nhpoole/mixed_signal_mmwave_edge_accelerator/simulations/cap_mult_test.spice

**.subckt cap_mult_test
C1 vcap GND 'Clpf' m=1 
R2 vbuf vlpf 'Rbase' m=1 
R3 vcap vlpf 'Kcap*Rbase' m=1 
R1 vlpf vin 'Rlpf' m=1 
x1 vbuf vcap vbuf se_fold_casc_wide_swing_opamp
**** begin user architecture code

.include ~/skywater-pdk/libraries/sky130_fd_pr_ngspice/latest/cells/nfet_01v8/sky130_fd_pr__nfet_01v8__tt.corner.spice
.include ~/skywater-pdk/libraries/sky130_fd_pr_ngspice/latest/cells/nfet_01v8_lvt/sky130_fd_pr__nfet_01v8_lvt__tt.corner.spice
.include ~/skywater-pdk/libraries/sky130_fd_pr_ngspice/latest/cells/pfet_01v8/sky130_fd_pr__pfet_01v8__tt.corner.spice
.include ~/skywater-pdk/libraries/sky130_fd_pr_ngspice/latest/cells/nfet_03v3_nvt/sky130_fd_pr__nfet_03v3_nvt__tt.corner.spice
.include ~/skywater-pdk/libraries/sky130_fd_pr_ngspice/latest/cells/nfet_05v0_nvt/sky130_fd_pr__nfet_05v0_nvt__tt.corner.spice
.include ~/skywater-pdk/libraries/sky130_fd_pr_ngspice/latest/cells/esd_nfet_01v8/sky130_fd_pr__esd_nfet_01v8__tt.corner.spice
.include ~/skywater-pdk/libraries/sky130_fd_pr_ngspice/latest/cells/pfet_01v8_lvt/sky130_fd_pr__pfet_01v8_lvt__tt.corner.spice
.include ~/skywater-pdk/libraries/sky130_fd_pr_ngspice/latest/cells/pfet_01v8_hvt/sky130_fd_pr__pfet_01v8_hvt__tt.corner.spice
.include ~/skywater-pdk/libraries/sky130_fd_pr_ngspice/latest/cells/esd_pfet_g5v0d10v5/sky130_fd_pr__esd_pfet_g5v0d10v5__tt.corner.spice
.include ~/skywater-pdk/libraries/sky130_fd_pr_ngspice/latest/cells/pfet_g5v0d10v5/sky130_fd_pr__pfet_g5v0d10v5__tt.corner.spice
.include ~/skywater-pdk/libraries/sky130_fd_pr_ngspice/latest/cells/pfet_g5v0d16v0/sky130_fd_pr__pfet_g5v0d16v0__tt.corner.spice
.include ~/skywater-pdk/libraries/sky130_fd_pr_ngspice/latest/cells/nfet_g5v0d10v5/sky130_fd_pr__nfet_g5v0d10v5__tt.corner.spice
.include ~/skywater-pdk/libraries/sky130_fd_pr_ngspice/latest/cells/nfet_g5v0d16v0/sky130_fd_pr__nfet_g5v0d16v0__tt_discrete.corner.spice
.include ~/skywater-pdk/libraries/sky130_fd_pr_ngspice/latest/cells/esd_nfet_g5v0d10v5/sky130_fd_pr__esd_nfet_g5v0d10v5__tt.corner.spice
.include ~/skywater-pdk/libraries/sky130_fd_pr_ngspice/latest/models/corners/tt/nonfet.spice
* Mismatch parameters
.include ~/skywater-pdk/libraries/sky130_fd_pr_ngspice/latest/cells/nfet_01v8/sky130_fd_pr__nfet_01v8__mismatch.corner.spice
.include ~/skywater-pdk/libraries/sky130_fd_pr_ngspice/latest/cells/pfet_01v8/sky130_fd_pr__pfet_01v8__mismatch.corner.spice
.include ~/skywater-pdk/libraries/sky130_fd_pr_ngspice/latest/cells/nfet_01v8_lvt/sky130_fd_pr__nfet_01v8_lvt__mismatch.corner.spice
.include ~/skywater-pdk/libraries/sky130_fd_pr_ngspice/latest/cells/pfet_01v8_lvt/sky130_fd_pr__pfet_01v8_lvt__mismatch.corner.spice
.include ~/skywater-pdk/libraries/sky130_fd_pr_ngspice/latest/cells/pfet_01v8_hvt/sky130_fd_pr__pfet_01v8_hvt__mismatch.corner.spice
.include ~/skywater-pdk/libraries/sky130_fd_pr_ngspice/latest/cells/nfet_g5v0d10v5/sky130_fd_pr__nfet_g5v0d10v5__mismatch.corner.spice
.include ~/skywater-pdk/libraries/sky130_fd_pr_ngspice/latest/cells/pfet_g5v0d10v5/sky130_fd_pr__pfet_g5v0d10v5__mismatch.corner.spice
.include ~/skywater-pdk/libraries/sky130_fd_pr_ngspice/latest/cells/nfet_05v0_nvt/sky130_fd_pr__nfet_05v0_nvt__mismatch.corner.spice
.include ~/skywater-pdk/libraries/sky130_fd_pr_ngspice/latest/cells/nfet_03v3_nvt/sky130_fd_pr__nfet_03v3_nvt__mismatch.corner.spice
* Resistor~/skywater-pdk/libraries/sky130_fd_pr_ngspice/latest/Capacitor
.include ~/skywater-pdk/libraries/sky130_fd_pr_ngspice/latest/models/r+c/res_typical__cap_typical.spice
.include ~/skywater-pdk/libraries/sky130_fd_pr_ngspice/latest/models/r+c/res_typical__cap_typical__lin.spice
* Special cells
.include ~/skywater-pdk/libraries/sky130_fd_pr_ngspice/latest/models/corners/tt/specialized_cells.spice
* All models
.include ~/skywater-pdk/libraries/sky130_fd_pr_ngspice/latest/models/all.spice
* Corner
.include ~/skywater-pdk/libraries/sky130_fd_pr_ngspice/latest/models/corners/tt/rf.spice

**** end user architecture code
**.ends

* expanding   symbol:
*+  /home/users/nhpoole/ee272b/ee272b_mixed_signal_mmwave_accelerator/designs/se_fold_casc_wide_swing_opamp.sym # of pins=3
* sym_path:
*+ /home/users/nhpoole/ee272b/ee272b_mixed_signal_mmwave_accelerator/designs/se_fold_casc_wide_swing_opamp.sym
* sch_path:
*+ /home/users/nhpoole/ee272b/ee272b_mixed_signal_mmwave_accelerator/designs/se_fold_casc_wide_swing_opamp.sch
.subckt se_fold_casc_wide_swing_opamp  vo vip vim
*.ipin vip
*.ipin vim
*.opin vo
V6 vtail_cascn net1 0
XM7 net1 vbias4 GND GND sky130_fd_pr__nfet_01v8 L='Lbias*nfactorL' W='Wbias*nfactorW' nf=1 ad='int((nf+1)/2) * W/nf * 0.29'
+ as='int((nf+2)/2) * W/nf * 0.29' pd='2*int((nf+1)/2) * (W/nf + 0.29)' ps='2*int((nf+2)/2) * (W/nf + 0.29)'
+ nrd='0.29 / W' nrs='0.29 / W' sa=0 sb=0 sd=0 mult='9*K' m='9*K' 
XM10 vcascnp vbias4 GND GND sky130_fd_pr__nfet_01v8 L='Lbias*nfactorL' W='2*Wbias*nfactorW' nf=1 ad='int((nf+1)/2) * W/nf * 0.29'
+ as='int((nf+2)/2) * W/nf * 0.29' pd='2*int((nf+1)/2) * (W/nf + 0.29)' ps='2*int((nf+2)/2) * (W/nf + 0.29)'
+ nrd='0.29 / W' nrs='0.29 / W' sa=0 sb=0 sd=0 mult='9*K' m='9*K' 
XM11 net11 vbias3 vcascnp GND sky130_fd_pr__nfet_01v8 L='Lbias*nfactorL' W='Wbias*nfactorW' nf=1 ad='int((nf+1)/2) * W/nf * 0.29'
+ as='int((nf+2)/2) * W/nf * 0.29' pd='2*int((nf+1)/2) * (W/nf + 0.29)' ps='2*int((nf+2)/2) * (W/nf + 0.29)'
+ nrd='0.29 / W' nrs='0.29 / W' sa=0 sb=0 sd=0 mult='9*K' m='9*K' 
XM27 vcascnm vbias4 GND GND sky130_fd_pr__nfet_01v8 L='Lbias*nfactorL' W='2*Wbias*nfactorW' nf=1 ad='int((nf+1)/2) * W/nf * 0.29'
+ as='int((nf+2)/2) * W/nf * 0.29' pd='2*int((nf+1)/2) * (W/nf + 0.29)' ps='2*int((nf+2)/2) * (W/nf + 0.29)'
+ nrd='0.29 / W' nrs='0.29 / W' sa=0 sb=0 sd=0 mult='9*K' m='9*K' 
XM28 vo vbias3 vcascnm GND sky130_fd_pr__nfet_01v8 L='Lbias*nfactorL' W='Wbias*nfactorW' nf=1 ad='int((nf+1)/2) * W/nf * 0.29'
+ as='int((nf+2)/2) * W/nf * 0.29' pd='2*int((nf+1)/2) * (W/nf + 0.29)' ps='2*int((nf+2)/2) * (W/nf + 0.29)'
+ nrd='0.29 / W' nrs='0.29 / W' sa=0 sb=0 sd=0 mult='9*K' m='9*K' 
XM36 vbias1 vbias2 net7 VDD sky130_fd_pr__pfet_01v8 L='Lbias' W='2*Wbias' nf=1 ad='int((nf+1)/2) * W/nf * 0.29'
+ as='int((nf+2)/2) * W/nf * 0.29' pd='2*int((nf+1)/2) * (W/nf + 0.29)' ps='2*int((nf+2)/2) * (W/nf + 0.29)'
+ nrd='0.29 / W' nrs='0.29 / W' sa=0 sb=0 sd=0 mult='9*K' m='9*K' 
XM37 net4 vbias2 net2 VDD sky130_fd_pr__pfet_01v8 L='Lbias' W='2*Wbias' nf=1 ad='int((nf+1)/2) * W/nf * 0.29'
+ as='int((nf+2)/2) * W/nf * 0.29' pd='2*int((nf+1)/2) * (W/nf + 0.29)' ps='2*int((nf+2)/2) * (W/nf + 0.29)'
+ nrd='0.29 / W' nrs='0.29 / W' sa=0 sb=0 sd=0 mult='9*K' m='9*K' 
XM38 net6 vbias2 net5 VDD sky130_fd_pr__pfet_01v8 L='Lbias' W='2*Wbias' nf=1 ad='int((nf+1)/2) * W/nf * 0.29'
+ as='int((nf+2)/2) * W/nf * 0.29' pd='2*int((nf+1)/2) * (W/nf + 0.29)' ps='2*int((nf+2)/2) * (W/nf + 0.29)'
+ nrd='0.29 / W' nrs='0.29 / W' sa=0 sb=0 sd=0 mult='9*K' m='9*K' 
XM39 vbias2 net3 vbias1 VDD sky130_fd_pr__pfet_01v8 L='Lbias' W='Wbias' nf=1 ad='int((nf+1)/2) * W/nf * 0.29'
+ as='int((nf+2)/2) * W/nf * 0.29' pd='2*int((nf+1)/2) * (W/nf + 0.29)' ps='2*int((nf+2)/2) * (W/nf + 0.29)'
+ nrd='0.29 / W' nrs='0.29 / W' sa=0 sb=0 sd=0 mult='3*K' m='3*K' 
XM40 net3 net3 vbias2 VDD sky130_fd_pr__pfet_01v8 L='Lbias' W='3*Wbias' nf=1 ad='int((nf+1)/2) * W/nf * 0.29'
+ as='int((nf+2)/2) * W/nf * 0.29' pd='2*int((nf+1)/2) * (W/nf + 0.29)' ps='2*int((nf+2)/2) * (W/nf + 0.29)'
+ nrd='0.29 / W' nrs='0.29 / W' sa=0 sb=0 sd=0 mult='9*K' m='9*K' 
XM41 net4 net4 vbias3 GND sky130_fd_pr__nfet_01v8 L='Lbias*nfactorL' W='3*Wbias*nfactorW' nf=1 ad='int((nf+1)/2) * W/nf * 0.29'
+ as='int((nf+2)/2) * W/nf * 0.29' pd='2*int((nf+1)/2) * (W/nf + 0.29)' ps='2*int((nf+2)/2) * (W/nf + 0.29)'
+ nrd='0.29 / W' nrs='0.29 / W' sa=0 sb=0 sd=0 mult='9*K' m='9*K' 
XM42 vbias3 net4 vbias4 GND sky130_fd_pr__nfet_01v8 L='Lbias*nfactorL' W='Wbias*nfactorW' nf=1 ad='int((nf+1)/2) * W/nf * 0.29'
+ as='int((nf+2)/2) * W/nf * 0.29' pd='2*int((nf+1)/2) * (W/nf + 0.29)' ps='2*int((nf+2)/2) * (W/nf + 0.29)'
+ nrd='0.29 / W' nrs='0.29 / W' sa=0 sb=0 sd=0 mult='K' m='K' 
XM43 vbias4 vbias3 net9 GND sky130_fd_pr__nfet_01v8 L='Lbias*nfactorL' W='Wbias*nfactorW' nf=1 ad='int((nf+1)/2) * W/nf * 0.29'
+ as='int((nf+2)/2) * W/nf * 0.29' pd='2*int((nf+1)/2) * (W/nf + 0.29)' ps='2*int((nf+2)/2) * (W/nf + 0.29)'
+ nrd='0.29 / W' nrs='0.29 / W' sa=0 sb=0 sd=0 mult='9*K' m='9*K' 
XM44 net10 vbias4 GND GND sky130_fd_pr__nfet_01v8 L='Lbias*nfactorL' W='Wbias*nfactorW' nf=1 ad='int((nf+1)/2) * W/nf * 0.29'
+ as='int((nf+2)/2) * W/nf * 0.29' pd='2*int((nf+1)/2) * (W/nf + 0.29)' ps='2*int((nf+2)/2) * (W/nf + 0.29)'
+ nrd='0.29 / W' nrs='0.29 / W' sa=0 sb=0 sd=0 mult='9*K' m='9*K' 
XM45 net6 net6 net8 net8 sky130_fd_pr__nfet_01v8 L='Lbias' W='0.6*Wbias' nf=1 ad='int((nf+1)/2) * W/nf * 0.29'
+ as='int((nf+2)/2) * W/nf * 0.29' pd='2*int((nf+1)/2) * (W/nf + 0.29)' ps='2*int((nf+2)/2) * (W/nf + 0.29)'
+ nrd='0.29 / W' nrs='0.29 / W' sa=0 sb=0 sd=0 mult='K' m='K' 
I1 net3 GND 'Ibias' 
V7 net8 GND 0
V8 net9 net10 0
XM8 vfoldp vip vtail_cascn GND sky130_fd_pr__nfet_01v8 L='K2*Lbias*nfactorL' W='Wbias*nfactorW' nf=1
+ ad='int((nf+1)/2) * W/nf * 0.29' as='int((nf+2)/2) * W/nf * 0.29' pd='2*int((nf+1)/2) * (W/nf + 0.29)'
+ ps='2*int((nf+2)/2) * (W/nf + 0.29)' nrd='0.29 / W' nrs='0.29 / W' sa=0 sb=0 sd=0 mult='9*K' m='9*K'
+ 
XM12 net11 vbias2 vfoldp VDD sky130_fd_pr__pfet_01v8 L='Lbias' W='2*Wbias' nf=1 ad='int((nf+1)/2) * W/nf * 0.29'
+ as='int((nf+2)/2) * W/nf * 0.29' pd='2*int((nf+1)/2) * (W/nf + 0.29)' ps='2*int((nf+2)/2) * (W/nf + 0.29)'
+ nrd='0.29 / W' nrs='0.29 / W' sa=0 sb=0 sd=0 mult='9*K' m='9*K' 
XM31 vo vbias2 vfoldm VDD sky130_fd_pr__pfet_01v8 L='Lbias' W='2*Wbias' nf=1 ad='int((nf+1)/2) * W/nf * 0.29'
+ as='int((nf+2)/2) * W/nf * 0.29' pd='2*int((nf+1)/2) * (W/nf + 0.29)' ps='2*int((nf+2)/2) * (W/nf + 0.29)'
+ nrd='0.29 / W' nrs='0.29 / W' sa=0 sb=0 sd=0 mult='9*K' m='9*K' 
XM15 vfoldp net11 VDD VDD sky130_fd_pr__pfet_01v8_lvt L='Lbias' W='4*Wbias' nf=1 ad='int((nf+1)/2) * W/nf * 0.29'
+ as='int((nf+2)/2) * W/nf * 0.29' pd='2*int((nf+1)/2) * (W/nf + 0.29)' ps='2*int((nf+2)/2) * (W/nf + 0.29)'
+ nrd='0.29 / W' nrs='0.29 / W' sa=0 sb=0 sd=0 mult='9*K' m='9*K' 
XM32 vfoldm net11 VDD VDD sky130_fd_pr__pfet_01v8_lvt L='Lbias' W='4*Wbias' nf=1 ad='int((nf+1)/2) * W/nf * 0.29'
+ as='int((nf+2)/2) * W/nf * 0.29' pd='2*int((nf+1)/2) * (W/nf + 0.29)' ps='2*int((nf+2)/2) * (W/nf + 0.29)'
+ nrd='0.29 / W' nrs='0.29 / W' sa=0 sb=0 sd=0 mult='9*K' m='9*K' 
XM33 net7 vbias1 VDD VDD sky130_fd_pr__pfet_01v8_lvt L='Lbias' W='2*Wbias' nf=1 ad='int((nf+1)/2) * W/nf * 0.29'
+ as='int((nf+2)/2) * W/nf * 0.29' pd='2*int((nf+1)/2) * (W/nf + 0.29)' ps='2*int((nf+2)/2) * (W/nf + 0.29)'
+ nrd='0.29 / W' nrs='0.29 / W' sa=0 sb=0 sd=0 mult='9*K' m='9*K' 
XM34 net2 vbias1 VDD VDD sky130_fd_pr__pfet_01v8_lvt L='Lbias' W='2*Wbias' nf=1 ad='int((nf+1)/2) * W/nf * 0.29'
+ as='int((nf+2)/2) * W/nf * 0.29' pd='2*int((nf+1)/2) * (W/nf + 0.29)' ps='2*int((nf+2)/2) * (W/nf + 0.29)'
+ nrd='0.29 / W' nrs='0.29 / W' sa=0 sb=0 sd=0 mult='9*K' m='9*K' 
XM35 net5 vbias1 VDD VDD sky130_fd_pr__pfet_01v8_lvt L='Lbias' W='2*Wbias' nf=1 ad='int((nf+1)/2) * W/nf * 0.29'
+ as='int((nf+2)/2) * W/nf * 0.29' pd='2*int((nf+1)/2) * (W/nf + 0.29)' ps='2*int((nf+2)/2) * (W/nf + 0.29)'
+ nrd='0.29 / W' nrs='0.29 / W' sa=0 sb=0 sd=0 mult='9*K' m='9*K' 
XM5 net1 vbias4 GND GND sky130_fd_pr__nfet_01v8 L='Lbias*nfactorL' W='Wbias*nfactorW' nf=1 ad='int((nf+1)/2) * W/nf * 0.29'
+ as='int((nf+2)/2) * W/nf * 0.29' pd='2*int((nf+1)/2) * (W/nf + 0.29)' ps='2*int((nf+2)/2) * (W/nf + 0.29)'
+ nrd='0.29 / W' nrs='0.29 / W' sa=0 sb=0 sd=0 mult='9*K' m='9*K' 
XM9 vfoldm vim vtail_cascn GND sky130_fd_pr__nfet_01v8 L='K2*Lbias*nfactorL' W='Wbias*nfactorW' nf=1
+ ad='int((nf+1)/2) * W/nf * 0.29' as='int((nf+2)/2) * W/nf * 0.29' pd='2*int((nf+1)/2) * (W/nf + 0.29)'
+ ps='2*int((nf+2)/2) * (W/nf + 0.29)' nrd='0.29 / W' nrs='0.29 / W' sa=0 sb=0 sd=0 mult='9*K' m='9*K'
+ 
XM4 vo_sf vbias4 GND GND sky130_fd_pr__nfet_01v8 L='Lbias*nfactorL' W='Wbias*nfactorW' nf=1 ad='int((nf+1)/2) * W/nf * 0.29'
+ as='int((nf+2)/2) * W/nf * 0.29' pd='2*int((nf+1)/2) * (W/nf + 0.29)' ps='2*int((nf+2)/2) * (W/nf + 0.29)'
+ nrd='0.29 / W' nrs='0.29 / W' sa=0 sb=0 sd=0 mult='1*K' m='1*K' 
XM14 GND vo_sf vo_cs VDD sky130_fd_pr__pfet_01v8_lvt L='Lbias' W='4*Wbias' nf=1 ad='int((nf+1)/2) * W/nf * 0.29'
+ as='int((nf+2)/2) * W/nf * 0.29' pd='2*int((nf+1)/2) * (W/nf + 0.29)' ps='2*int((nf+2)/2) * (W/nf + 0.29)'
+ nrd='0.29 / W' nrs='0.29 / W' sa=0 sb=0 sd=0 mult='18*K' m='18*K' 
XM16 vo_cs vbias1 VDD VDD sky130_fd_pr__pfet_01v8_lvt L='Lbias' W='0.5*Wbias' nf=1 ad='int((nf+1)/2) * W/nf * 0.29'
+ as='int((nf+2)/2) * W/nf * 0.29' pd='2*int((nf+1)/2) * (W/nf + 0.29)' ps='2*int((nf+2)/2) * (W/nf + 0.29)'
+ nrd='0.29 / W' nrs='0.29 / W' sa=0 sb=0 sd=0 mult='1*K' m='1*K' 
C1 vcascnm vo_sf 0p m=1
XM6 net12 vbias1 VDD VDD sky130_fd_pr__pfet_01v8_lvt L='Lbias' W='2*Wbias' nf=1 ad='int((nf+1)/2) * W/nf * 0.29'
+ as='int((nf+2)/2) * W/nf * 0.29' pd='2*int((nf+1)/2) * (W/nf + 0.29)' ps='2*int((nf+2)/2) * (W/nf + 0.29)'
+ nrd='0.29 / W' nrs='0.29 / W' sa=0 sb=0 sd=0 mult='9*K' m='9*K' 
V1 net12 vtail_cascp 0
XM13 net12 vbias1 VDD VDD sky130_fd_pr__pfet_01v8_lvt L='Lbias' W='2*Wbias' nf=1 ad='int((nf+1)/2) * W/nf * 0.29'
+ as='int((nf+2)/2) * W/nf * 0.29' pd='2*int((nf+1)/2) * (W/nf + 0.29)' ps='2*int((nf+2)/2) * (W/nf + 0.29)'
+ nrd='0.29 / W' nrs='0.29 / W' sa=0 sb=0 sd=0 mult='9*K' m='9*K' 
XM2 vcascnm vim vtail_cascp VDD sky130_fd_pr__pfet_01v8_lvt L='Lbias' W='2*Wbias' nf=1 ad='int((nf+1)/2) * W/nf * 0.29'
+ as='int((nf+2)/2) * W/nf * 0.29' pd='2*int((nf+1)/2) * (W/nf + 0.29)' ps='2*int((nf+2)/2) * (W/nf + 0.29)'
+ nrd='0.29 / W' nrs='0.29 / W' sa=0 sb=0 sd=0 mult='9*K' m='9*K' 
XM3 vcascnp vip vtail_cascp VDD sky130_fd_pr__pfet_01v8_lvt L='Lbias' W='2*Wbias' nf=1 ad='int((nf+1)/2) * W/nf * 0.29'
+ as='int((nf+2)/2) * W/nf * 0.29' pd='2*int((nf+1)/2) * (W/nf + 0.29)' ps='2*int((nf+2)/2) * (W/nf + 0.29)'
+ nrd='0.29 / W' nrs='0.29 / W' sa=0 sb=0 sd=0 mult='9*K' m='9*K' 
XM17 net13 vbias4_ GND GND sky130_fd_pr__nfet_01v8 L='Lbias*nfactorL' W='Wbias*nfactorW' nf=1 ad='int((nf+1)/2) * W/nf * 0.29'
+ as='int((nf+2)/2) * W/nf * 0.29' pd='2*int((nf+1)/2) * (W/nf + 0.29)' ps='2*int((nf+2)/2) * (W/nf + 0.29)'
+ nrd='0.29 / W' nrs='0.29 / W' sa=0 sb=0 sd=0 mult='9*K' m='9*K' 
XM18 vbias4_ vbias4_ GND GND sky130_fd_pr__nfet_01v8 L='Lbias*nfactorL' W='Wbias*nfactorW' nf=1 ad='int((nf+1)/2) * W/nf * 0.29'
+ as='int((nf+2)/2) * W/nf * 0.29' pd='2*int((nf+1)/2) * (W/nf + 0.29)' ps='2*int((nf+2)/2) * (W/nf + 0.29)'
+ nrd='0.29 / W' nrs='0.29 / W' sa=0 sb=0 sd=0 mult='9*K' m='9*K' 
XM19 net15 net15 vbias4_ GND sky130_fd_pr__nfet_01v8 L='Lbias*nfactorL' W='Wbias*nfactorW' nf=1 ad='int((nf+1)/2) * W/nf * 0.29'
+ as='int((nf+2)/2) * W/nf * 0.29' pd='2*int((nf+1)/2) * (W/nf + 0.29)' ps='2*int((nf+2)/2) * (W/nf + 0.29)'
+ nrd='0.29 / W' nrs='0.29 / W' sa=0 sb=0 sd=0 mult='9*K' m='9*K' 
XM20 net14 net15 net13 GND sky130_fd_pr__nfet_01v8 L='Lbias*nfactorL' W='Wbias*nfactorW' nf=1 ad='int((nf+1)/2) * W/nf * 0.29'
+ as='int((nf+2)/2) * W/nf * 0.29' pd='2*int((nf+1)/2) * (W/nf + 0.29)' ps='2*int((nf+2)/2) * (W/nf + 0.29)'
+ nrd='0.29 / W' nrs='0.29 / W' sa=0 sb=0 sd=0 mult='9*K' m='9*K' 
I2 VDD net15 'Ibias' 
XM25 net14 net14 vbias2_ VDD sky130_fd_pr__pfet_01v8 L='Lbias' W='2*Wbias' nf=1 ad='int((nf+1)/2) * W/nf * 0.29'
+ as='int((nf+2)/2) * W/nf * 0.29' pd='2*int((nf+1)/2) * (W/nf + 0.29)' ps='2*int((nf+2)/2) * (W/nf + 0.29)'
+ nrd='0.29 / W' nrs='0.29 / W' sa=0 sb=0 sd=0 mult='9*K' m='9*K' 
XM26 vbias2_ net14 VDD VDD sky130_fd_pr__pfet_01v8_lvt L='Lbias' W='4*Wbias' nf=1 ad='int((nf+1)/2) * W/nf * 0.29'
+ as='int((nf+2)/2) * W/nf * 0.29' pd='2*int((nf+1)/2) * (W/nf + 0.29)' ps='2*int((nf+2)/2) * (W/nf + 0.29)'
+ nrd='0.29 / W' nrs='0.29 / W' sa=0 sb=0 sd=0 mult='9*K' m='9*K' 
XM21 vbias3_ net17 GND GND sky130_fd_pr__nfet_01v8 L='Lbias*nfactorL' W='Wbias*nfactorW' nf=1 ad='int((nf+1)/2) * W/nf * 0.29'
+ as='int((nf+2)/2) * W/nf * 0.29' pd='2*int((nf+1)/2) * (W/nf + 0.29)' ps='2*int((nf+2)/2) * (W/nf + 0.29)'
+ nrd='0.29 / W' nrs='0.29 / W' sa=0 sb=0 sd=0 mult='9*K' m='9*K' 
XM22 net16 vbias4_ GND GND sky130_fd_pr__nfet_01v8 L='Lbias*nfactorL' W='Wbias*nfactorW' nf=1 ad='int((nf+1)/2) * W/nf * 0.29'
+ as='int((nf+2)/2) * W/nf * 0.29' pd='2*int((nf+1)/2) * (W/nf + 0.29)' ps='2*int((nf+2)/2) * (W/nf + 0.29)'
+ nrd='0.29 / W' nrs='0.29 / W' sa=0 sb=0 sd=0 mult='9*K' m='9*K' 
XM23 net19 net15 net16 GND sky130_fd_pr__nfet_01v8 L='Lbias*nfactorL' W='Wbias*nfactorW' nf=1 ad='int((nf+1)/2) * W/nf * 0.29'
+ as='int((nf+2)/2) * W/nf * 0.29' pd='2*int((nf+1)/2) * (W/nf + 0.29)' ps='2*int((nf+2)/2) * (W/nf + 0.29)'
+ nrd='0.29 / W' nrs='0.29 / W' sa=0 sb=0 sd=0 mult='9*K' m='9*K' 
XM24 net17 net17 vbias3_ GND sky130_fd_pr__nfet_01v8 L='Lbias*nfactorL' W='Wbias*nfactorW' nf=1 ad='int((nf+1)/2) * W/nf * 0.29'
+ as='int((nf+2)/2) * W/nf * 0.29' pd='2*int((nf+1)/2) * (W/nf + 0.29)' ps='2*int((nf+2)/2) * (W/nf + 0.29)'
+ nrd='0.29 / W' nrs='0.29 / W' sa=0 sb=0 sd=0 mult='9*K' m='9*K' 
XM29 net17 net19 net18 VDD sky130_fd_pr__pfet_01v8 L='Lbias' W='2*Wbias' nf=1 ad='int((nf+1)/2) * W/nf * 0.29'
+ as='int((nf+2)/2) * W/nf * 0.29' pd='2*int((nf+1)/2) * (W/nf + 0.29)' ps='2*int((nf+2)/2) * (W/nf + 0.29)'
+ nrd='0.29 / W' nrs='0.29 / W' sa=0 sb=0 sd=0 mult='9*K' m='9*K' 
XM30 net18 vbias1_ VDD VDD sky130_fd_pr__pfet_01v8_lvt L='Lbias' W='4*Wbias' nf=1 ad='int((nf+1)/2) * W/nf * 0.29'
+ as='int((nf+2)/2) * W/nf * 0.29' pd='2*int((nf+1)/2) * (W/nf + 0.29)' ps='2*int((nf+2)/2) * (W/nf + 0.29)'
+ nrd='0.29 / W' nrs='0.29 / W' sa=0 sb=0 sd=0 mult='9*K' m='9*K' 
XM46 net19 net19 vbias1_ VDD sky130_fd_pr__pfet_01v8 L='Lbias' W='2*Wbias' nf=1 ad='int((nf+1)/2) * W/nf * 0.29'
+ as='int((nf+2)/2) * W/nf * 0.29' pd='2*int((nf+1)/2) * (W/nf + 0.29)' ps='2*int((nf+2)/2) * (W/nf + 0.29)'
+ nrd='0.29 / W' nrs='0.29 / W' sa=0 sb=0 sd=0 mult='9*K' m='9*K' 
XM47 vbias1_ vbias1_ VDD VDD sky130_fd_pr__pfet_01v8_lvt L='Lbias' W='4*Wbias' nf=1 ad='int((nf+1)/2) * W/nf * 0.29'
+ as='int((nf+2)/2) * W/nf * 0.29' pd='2*int((nf+1)/2) * (W/nf + 0.29)' ps='2*int((nf+2)/2) * (W/nf + 0.29)'
+ nrd='0.29 / W' nrs='0.29 / W' sa=0 sb=0 sd=0 mult='9*K' m='9*K' 
XM1 vo_sf vo_sf VDD VDD sky130_fd_pr__pfet_01v8 L='Lbias' W='3.5*Wbias' nf=1 ad='int((nf+1)/2) * W/nf * 0.29'
+ as='int((nf+2)/2) * W/nf * 0.29' pd='2*int((nf+1)/2) * (W/nf + 0.29)' ps='2*int((nf+2)/2) * (W/nf + 0.29)'
+ nrd='0.29 / W' nrs='0.29 / W' sa=0 sb=0 sd=0 mult='1*K' m='1*K' 
C2 vo GND 1p m=1
.ends

.GLOBAL GND
.GLOBAL VDD
**** begin user architecture code

.include cap_mult_test_commands.spice

**** end user architecture code
** flattened .save nodes
.end
