nhpoole/mixed_signal_mmwave_edge_accelerator/simulations/dff_test.spice

**.subckt dff_test
V1 vpbias net1 0
XM6 net1 vctrl GND GND sky130_fd_pr__nfet_01v8 L='Lnmos' W='Wnbias' nf=1 ad='int((nf+1)/2) * W/nf * 0.29'
+ as='int((nf+2)/2) * W/nf * 0.29' pd='2*int((nf+1)/2) * (W/nf + 0.29)' ps='2*int((nf+2)/2) * (W/nf + 0.29)'
+ nrd='0.29 / W' nrs='0.29 / W' sa=0 sb=0 sd=0 mult='Mnmos' m='Mnmos' 
XM3 vpbias vpbias VDD VDD sky130_fd_pr__pfet_01v8_hvt L='Lpmos' W='Wpbias' nf=1 ad='int((nf+1)/2) * W/nf * 0.29'
+ as='int((nf+2)/2) * W/nf * 0.29' pd='2*int((nf+1)/2) * (W/nf + 0.29)' ps='2*int((nf+2)/2) * (W/nf + 0.29)'
+ nrd='0.29 / W' nrs='0.29 / W' sa=0 sb=0 sd=0 mult='Mpmos' m='Mpmos' 
x1 vpbias net3 vin vctrl cs_ring_osc_stage
x2 vpbias net4 net3 vctrl cs_ring_osc_stage
x3 vpbias net5 net4 vctrl cs_ring_osc_stage
x4 vpbias net6 net5 vctrl cs_ring_osc_stage
x5 vpbias net7 net6 vctrl cs_ring_osc_stage
x6 vpbias net2 net7 vctrl cs_ring_osc_stage
XM21 vin net2 GND GND sky130_fd_pr__nfet_01v8 L='Lnmos' W='Wninv' nf=1 ad='int((nf+1)/2) * W/nf * 0.29'
+ as='int((nf+2)/2) * W/nf * 0.29' pd='2*int((nf+1)/2) * (W/nf + 0.29)' ps='2*int((nf+2)/2) * (W/nf + 0.29)'
+ nrd='0.29 / W' nrs='0.29 / W' sa=0 sb=0 sd=0 mult='Mnmos' m='Mnmos' 
XM22 vin net2 VDD VDD sky130_fd_pr__pfet_01v8_hvt L='Lpmos' W='Wpinv' nf=1 ad='int((nf+1)/2) * W/nf * 0.29'
+ as='int((nf+2)/2) * W/nf * 0.29' pd='2*int((nf+1)/2) * (W/nf + 0.29)' ps='2*int((nf+2)/2) * (W/nf + 0.29)'
+ nrd='0.29 / W' nrs='0.29 / W' sa=0 sb=0 sd=0 mult='Mpmos' m='Mpmos' 
C1 vin GND 1p m=1
XM1 vin2 vin GND GND sky130_fd_pr__nfet_01v8 L=0.15 W=0.65 nf=1 ad='int((nf+1)/2) * W/nf * 0.29' as='int((nf+2)/2) * W/nf * 0.29'
+ pd='2*int((nf+1)/2) * (W/nf + 0.29)' ps='2*int((nf+2)/2) * (W/nf + 0.29)' nrd='0.29 / W' nrs='0.29 / W'
+ sa=0 sb=0 sd=0 mult=1 m=1 
XM2 vin2 vin VDD VDD sky130_fd_pr__pfet_01v8_hvt L=0.15 W=1 nf=1 ad='int((nf+1)/2) * W/nf * 0.29' as='int((nf+2)/2) * W/nf * 0.29'
+ pd='2*int((nf+1)/2) * (W/nf + 0.29)' ps='2*int((nf+2)/2) * (W/nf + 0.29)' nrd='0.29 / W' nrs='0.29 / W'
+ sa=0 sb=0 sd=0 mult=1 m=1 
XM4 vin_buf vin2 GND GND sky130_fd_pr__nfet_01v8 L=0.15 W=0.65 nf=1 ad='int((nf+1)/2) * W/nf * 0.29'
+ as='int((nf+2)/2) * W/nf * 0.29' pd='2*int((nf+1)/2) * (W/nf + 0.29)' ps='2*int((nf+2)/2) * (W/nf + 0.29)'
+ nrd='0.29 / W' nrs='0.29 / W' sa=0 sb=0 sd=0 mult=4 m=4 
XM5 vin_buf vin2 VDD VDD sky130_fd_pr__pfet_01v8_hvt L=0.15 W=1 nf=1 ad='int((nf+1)/2) * W/nf * 0.29'
+ as='int((nf+2)/2) * W/nf * 0.29' pd='2*int((nf+1)/2) * (W/nf + 0.29)' ps='2*int((nf+2)/2) * (W/nf + 0.29)'
+ nrd='0.29 / W' nrs='0.29 / W' sa=0 sb=0 sd=0 mult=4 m=4 
**** begin user architecture code

.include ~/skywater-pdk/libraries/sky130_fd_pr_ngspice/latest/cells/nfet_01v8/sky130_fd_pr__nfet_01v8__tt.corner.spice
.include ~/skywater-pdk/libraries/sky130_fd_pr_ngspice/latest/cells/nfet_01v8_lvt/sky130_fd_pr__nfet_01v8_lvt__tt.corner.spice
.include ~/skywater-pdk/libraries/sky130_fd_pr_ngspice/latest/cells/pfet_01v8/sky130_fd_pr__pfet_01v8__tt.corner.spice
.include ~/skywater-pdk/libraries/sky130_fd_pr_ngspice/latest/cells/nfet_03v3_nvt/sky130_fd_pr__nfet_03v3_nvt__tt.corner.spice
.include ~/skywater-pdk/libraries/sky130_fd_pr_ngspice/latest/cells/nfet_05v0_nvt/sky130_fd_pr__nfet_05v0_nvt__tt.corner.spice
.include ~/skywater-pdk/libraries/sky130_fd_pr_ngspice/latest/cells/esd_nfet_01v8/sky130_fd_pr__esd_nfet_01v8__tt.corner.spice
.include ~/skywater-pdk/libraries/sky130_fd_pr_ngspice/latest/cells/pfet_01v8_lvt/sky130_fd_pr__pfet_01v8_lvt__tt.corner.spice
.include ~/skywater-pdk/libraries/sky130_fd_pr_ngspice/latest/cells/pfet_01v8_hvt/sky130_fd_pr__pfet_01v8_hvt__tt.corner.spice
.include ~/skywater-pdk/libraries/sky130_fd_pr_ngspice/latest/cells/esd_pfet_g5v0d10v5/sky130_fd_pr__esd_pfet_g5v0d10v5__tt.corner.spice
.include ~/skywater-pdk/libraries/sky130_fd_pr_ngspice/latest/cells/pfet_g5v0d10v5/sky130_fd_pr__pfet_g5v0d10v5__tt.corner.spice
.include ~/skywater-pdk/libraries/sky130_fd_pr_ngspice/latest/cells/pfet_g5v0d16v0/sky130_fd_pr__pfet_g5v0d16v0__tt.corner.spice
.include ~/skywater-pdk/libraries/sky130_fd_pr_ngspice/latest/cells/nfet_g5v0d10v5/sky130_fd_pr__nfet_g5v0d10v5__tt.corner.spice
.include ~/skywater-pdk/libraries/sky130_fd_pr_ngspice/latest/cells/nfet_g5v0d16v0/sky130_fd_pr__nfet_g5v0d16v0__tt_discrete.corner.spice
.include ~/skywater-pdk/libraries/sky130_fd_pr_ngspice/latest/cells/esd_nfet_g5v0d10v5/sky130_fd_pr__esd_nfet_g5v0d10v5__tt.corner.spice
.include ~/skywater-pdk/libraries/sky130_fd_pr_ngspice/latest/models/corners/tt/nonfet.spice
* Standard cells
.include ~/skywater-pdk/libraries/sky130_fd_sc_hd/latest/cells/dfxbp/sky130_fd_sc_hd__dfxbp_1.spice
.include ~/skywater-pdk/libraries/sky130_fd_sc_hd/latest/cells/dfxbp/sky130_fd_sc_hd__dfxbp_2.spice
* Mismatch parameters
.include ~/skywater-pdk/libraries/sky130_fd_pr_ngspice/latest/cells/nfet_01v8/sky130_fd_pr__nfet_01v8__mismatch.corner.spice
.include ~/skywater-pdk/libraries/sky130_fd_pr_ngspice/latest/cells/pfet_01v8/sky130_fd_pr__pfet_01v8__mismatch.corner.spice
.include ~/skywater-pdk/libraries/sky130_fd_pr_ngspice/latest/cells/nfet_01v8_lvt/sky130_fd_pr__nfet_01v8_lvt__mismatch.corner.spice
.include ~/skywater-pdk/libraries/sky130_fd_pr_ngspice/latest/cells/pfet_01v8_lvt/sky130_fd_pr__pfet_01v8_lvt__mismatch.corner.spice
.include ~/skywater-pdk/libraries/sky130_fd_pr_ngspice/latest/cells/pfet_01v8_hvt/sky130_fd_pr__pfet_01v8_hvt__mismatch.corner.spice
.include ~/skywater-pdk/libraries/sky130_fd_pr_ngspice/latest/cells/nfet_g5v0d10v5/sky130_fd_pr__nfet_g5v0d10v5__mismatch.corner.spice
.include ~/skywater-pdk/libraries/sky130_fd_pr_ngspice/latest/cells/pfet_g5v0d10v5/sky130_fd_pr__pfet_g5v0d10v5__mismatch.corner.spice
.include ~/skywater-pdk/libraries/sky130_fd_pr_ngspice/latest/cells/nfet_05v0_nvt/sky130_fd_pr__nfet_05v0_nvt__mismatch.corner.spice
.include ~/skywater-pdk/libraries/sky130_fd_pr_ngspice/latest/cells/nfet_03v3_nvt/sky130_fd_pr__nfet_03v3_nvt__mismatch.corner.spice
* Resistor~/skywater-pdk/libraries/sky130_fd_pr_ngspice/latest/Capacitor
.include ~/skywater-pdk/libraries/sky130_fd_pr_ngspice/latest/models/r+c/res_typical__cap_typical.spice
.include ~/skywater-pdk/libraries/sky130_fd_pr_ngspice/latest/models/r+c/res_typical__cap_typical__lin.spice
* Special cells
.include ~/skywater-pdk/libraries/sky130_fd_pr_ngspice/latest/models/corners/tt/specialized_cells.spice
* All models
.include ~/skywater-pdk/libraries/sky130_fd_pr_ngspice/latest/models/all.spice
* Corner
.include ~/skywater-pdk/libraries/sky130_fd_pr_ngspice/latest/models/corners/tt/rf.spice

**** end user architecture code
**.ends

* expanding   symbol:
*+  /home/users/nhpoole/ee272b/ee272b_mixed_signal_mmwave_accelerator/designs/cs_ring_osc_stage.sym # of pins=4
* sym_path:
*+ /home/users/nhpoole/ee272b/ee272b_mixed_signal_mmwave_accelerator/designs/cs_ring_osc_stage.sym
* sch_path:
*+ /home/users/nhpoole/ee272b/ee272b_mixed_signal_mmwave_accelerator/designs/cs_ring_osc_stage.sch
.subckt cs_ring_osc_stage  vbiasp vout vin vbiasn
*.opin vout
*.ipin vin
*.ipin vbiasn
*.ipin vbiasp
XM2 net2 vin net3 GND sky130_fd_pr__nfet_01v8 L='Lnmos' W='Wnint' nf=1 ad='int((nf+1)/2) * W/nf * 0.29'
+ as='int((nf+2)/2) * W/nf * 0.29' pd='2*int((nf+1)/2) * (W/nf + 0.29)' ps='2*int((nf+2)/2) * (W/nf + 0.29)'
+ nrd='0.29 / W' nrs='0.29 / W' sa=0 sb=0 sd=0 mult='Mnmos' m='Mnmos' 
XM5 net3 vbiasn GND GND sky130_fd_pr__nfet_01v8 L='Lnmos' W='Wnbias' nf=1 ad='int((nf+1)/2) * W/nf * 0.29'
+ as='int((nf+2)/2) * W/nf * 0.29' pd='2*int((nf+1)/2) * (W/nf + 0.29)' ps='2*int((nf+2)/2) * (W/nf + 0.29)'
+ nrd='0.29 / W' nrs='0.29 / W' sa=0 sb=0 sd=0 mult='Mnmos' m='Mnmos' 
XM4 net2 vin net1 VDD sky130_fd_pr__pfet_01v8 L='Lpmos' W='Wpint' nf=1 ad='int((nf+1)/2) * W/nf * 0.29'
+ as='int((nf+2)/2) * W/nf * 0.29' pd='2*int((nf+1)/2) * (W/nf + 0.29)' ps='2*int((nf+2)/2) * (W/nf + 0.29)'
+ nrd='0.29 / W' nrs='0.29 / W' sa=0 sb=0 sd=0 mult='Mpmos' m='Mpmos' 
XM1 net1 vbiasp VDD VDD sky130_fd_pr__pfet_01v8_hvt L='Lpmos' W='Wpbias' nf=1 ad='int((nf+1)/2) * W/nf * 0.29'
+ as='int((nf+2)/2) * W/nf * 0.29' pd='2*int((nf+1)/2) * (W/nf + 0.29)' ps='2*int((nf+2)/2) * (W/nf + 0.29)'
+ nrd='0.29 / W' nrs='0.29 / W' sa=0 sb=0 sd=0 mult='Mpmos' m='Mpmos' 
XM7 vout net2 GND GND sky130_fd_pr__nfet_01v8 L='Lnmos' W='Wninv' nf=1 ad='int((nf+1)/2) * W/nf * 0.29'
+ as='int((nf+2)/2) * W/nf * 0.29' pd='2*int((nf+1)/2) * (W/nf + 0.29)' ps='2*int((nf+2)/2) * (W/nf + 0.29)'
+ nrd='0.29 / W' nrs='0.29 / W' sa=0 sb=0 sd=0 mult='Mnmos' m='Mnmos' 
XM8 vout net2 VDD VDD sky130_fd_pr__pfet_01v8_hvt L='Lpmos' W='Wpinv' nf=1 ad='int((nf+1)/2) * W/nf * 0.29'
+ as='int((nf+2)/2) * W/nf * 0.29' pd='2*int((nf+1)/2) * (W/nf + 0.29)' ps='2*int((nf+2)/2) * (W/nf + 0.29)'
+ nrd='0.29 / W' nrs='0.29 / W' sa=0 sb=0 sd=0 mult='Mpmos' m='Mpmos' 
.ends

.GLOBAL VDD
.GLOBAL GND
**** begin user architecture code

.include dff_test_commands.spice

**** end user architecture code
** flattened .save nodes
.end
