nhpoole/mixed_signal_mmwave_edge_accelerator/simulations/inv_test.spice

.subckt inv_test VDD in VSS out out2
*.ipin VDD
*.ipin in
*.ipin VSS
*.opin out
*.opin out2
XM2 out in VSS VSS sky130_fd_pr__nfet_01v8 L=0.15 W=0.65 nf=1 ad='int((nf+1)/2) * W/nf * 0.29' as='int((nf+2)/2) * W/nf * 0.29'
+ pd='2*int((nf+1)/2) * (W/nf + 0.29)' ps='2*int((nf+2)/2) * (W/nf + 0.29)' nrd='0.29 / W' nrs='0.29 / W'
+ sa=0 sb=0 sd=0 mult=1 m=1 
XM1 out in VDD VDD sky130_fd_pr__pfet_01v8_hvt L=0.15 W=1 nf=1 ad='int((nf+1)/2) * W/nf * 0.29' as='int((nf+2)/2) * W/nf * 0.29'
+ pd='2*int((nf+1)/2) * (W/nf + 0.29)' ps='2*int((nf+2)/2) * (W/nf + 0.29)' nrd='0.29 / W' nrs='0.29 / W'
+ sa=0 sb=0 sd=0 mult=1 m=1 
x1 in VSS VSS VDD VDD out2 sky130_fd_sc_hd__inv_1
**** begin user architecture code
.ends

.subckt sky130_fd_sc_hd__inv_1 A VGND VNB VPB VPWR Y
X0 VGND A Y VNB sky130_fd_pr__nfet_01v8 w=650000u l=150000u
X1 VPWR A Y VPB sky130_fd_pr__pfet_01v8_hvt w=1e+06u l=150000u
.ends
