nhpoole/mixed_signal_mmwave_edge_accelerator/simulations/test_circuit.spice

**.subckt inv_test
V1 net3 net4 0
XM6 net4 vctrl GND GND sky130_fd_pr__nfet_01v8 L='Lnmos' W='Wnbias' nf=1 ad='int((nf+1)/2) * W/nf * 0.29'
+ as='int((nf+2)/2) * W/nf * 0.29' pd='2*int((nf+1)/2) * (W/nf + 0.29)' ps='2*int((nf+2)/2) * (W/nf + 0.29)'
+ nrd='0.29 / W' nrs='0.29 / W' sa=0 sb=0 sd=0 mult='Mnmos' m='Mnmos' 
XM2 vout vin net2 GND sky130_fd_pr__nfet_01v8 L='Lnmos' W='Wnint' nf=1 ad='int((nf+1)/2) * W/nf * 0.29'
+ as='int((nf+2)/2) * W/nf * 0.29' pd='2*int((nf+1)/2) * (W/nf + 0.29)' ps='2*int((nf+2)/2) * (W/nf + 0.29)'
+ nrd='0.29 / W' nrs='0.29 / W' sa=0 sb=0 sd=0 mult='Mnmos' m='Mnmos' 
XM1 net1 net3 VDD VDD sky130_fd_pr__pfet_01v8 L='Lpmos' W='Wpbias' nf=1 ad='int((nf+1)/2) * W/nf * 0.29'
+ as='int((nf+2)/2) * W/nf * 0.29' pd='2*int((nf+1)/2) * (W/nf + 0.29)' ps='2*int((nf+2)/2) * (W/nf + 0.29)'
+ nrd='0.29 / W' nrs='0.29 / W' sa=0 sb=0 sd=0 mult='Mpmos' m='Mpmos' 
XM5 net2 vctrl GND GND sky130_fd_pr__nfet_01v8 L='Lnmos' W='Wnbias' nf=1 ad='int((nf+1)/2) * W/nf * 0.29'
+ as='int((nf+2)/2) * W/nf * 0.29' pd='2*int((nf+1)/2) * (W/nf + 0.29)' ps='2*int((nf+2)/2) * (W/nf + 0.29)'
+ nrd='0.29 / W' nrs='0.29 / W' sa=0 sb=0 sd=0 mult='Mnmos' m='Mnmos' 
XM3 net3 net3 VDD VDD sky130_fd_pr__pfet_01v8 L='Lpmos' W='Wpbias' nf=1 ad='int((nf+1)/2) * W/nf * 0.29'
+ as='int((nf+2)/2) * W/nf * 0.29' pd='2*int((nf+1)/2) * (W/nf + 0.29)' ps='2*int((nf+2)/2) * (W/nf + 0.29)'
+ nrd='0.29 / W' nrs='0.29 / W' sa=0 sb=0 sd=0 mult='Mpmos' m='Mpmos' 
XM4 vout vin net1 VDD sky130_fd_pr__pfet_01v8 L='Lpmos' W='Wpint' nf=1 ad='int((nf+1)/2) * W/nf * 0.29'
+ as='int((nf+2)/2) * W/nf * 0.29' pd='2*int((nf+1)/2) * (W/nf + 0.29)' ps='2*int((nf+2)/2) * (W/nf + 0.29)'
+ nrd='0.29 / W' nrs='0.29 / W' sa=0 sb=0 sd=0 mult='Mpmos' m='Mpmos' 

**** begin user architecture code

*.lib ~/skywater-pdk/libraries/sky130_fd_pr_ngspice/latest/models/sky130.lib.spice tt
.include ~/skywater-pdk/libraries/sky130_fd_pr_ngspice/latest/cells/nfet_01v8/sky130_fd_pr__nfet_01v8__tt.corner.spice
.include ~/skywater-pdk/libraries/sky130_fd_pr_ngspice/latest/cells/nfet_01v8_lvt/sky130_fd_pr__nfet_01v8_lvt__tt.corner.spice
.include ~/skywater-pdk/libraries/sky130_fd_pr_ngspice/latest/cells/pfet_01v8/sky130_fd_pr__pfet_01v8__tt.corner.spice
.include ~/skywater-pdk/libraries/sky130_fd_pr_ngspice/latest/cells/nfet_03v3_nvt/sky130_fd_pr__nfet_03v3_nvt__tt.corner.spice
.include ~/skywater-pdk/libraries/sky130_fd_pr_ngspice/latest/cells/nfet_05v0_nvt/sky130_fd_pr__nfet_05v0_nvt__tt.corner.spice
.include ~/skywater-pdk/libraries/sky130_fd_pr_ngspice/latest/cells/esd_nfet_01v8/sky130_fd_pr__esd_nfet_01v8__tt.corner.spice
.include ~/skywater-pdk/libraries/sky130_fd_pr_ngspice/latest/cells/pfet_01v8_lvt/sky130_fd_pr__pfet_01v8_lvt__tt.corner.spice
.include ~/skywater-pdk/libraries/sky130_fd_pr_ngspice/latest/cells/pfet_01v8_hvt/sky130_fd_pr__pfet_01v8_hvt__tt.corner.spice
.include ~/skywater-pdk/libraries/sky130_fd_pr_ngspice/latest/cells/esd_pfet_g5v0d10v5/sky130_fd_pr__esd_pfet_g5v0d10v5__tt.corner.spice
.include ~/skywater-pdk/libraries/sky130_fd_pr_ngspice/latest/cells/pfet_g5v0d10v5/sky130_fd_pr__pfet_g5v0d10v5__tt.corner.spice
.include ~/skywater-pdk/libraries/sky130_fd_pr_ngspice/latest/cells/pfet_g5v0d16v0/sky130_fd_pr__pfet_g5v0d16v0__tt.corner.spice
.include ~/skywater-pdk/libraries/sky130_fd_pr_ngspice/latest/cells/nfet_g5v0d10v5/sky130_fd_pr__nfet_g5v0d10v5__tt.corner.spice
.include ~/skywater-pdk/libraries/sky130_fd_pr_ngspice/latest/cells/nfet_g5v0d16v0/sky130_fd_pr__nfet_g5v0d16v0__tt_discrete.corner.spice
.include ~/skywater-pdk/libraries/sky130_fd_pr_ngspice/latest/cells/esd_nfet_g5v0d10v5/sky130_fd_pr__esd_nfet_g5v0d10v5__tt.corner.spice
.include ~/skywater-pdk/libraries/sky130_fd_pr_ngspice/latest/models/corners/tt/nonfet.spice
* Mismatch parameters
.include ~/skywater-pdk/libraries/sky130_fd_pr_ngspice/latest/cells/nfet_01v8/sky130_fd_pr__nfet_01v8__mismatch.corner.spice
.include ~/skywater-pdk/libraries/sky130_fd_pr_ngspice/latest/cells/pfet_01v8/sky130_fd_pr__pfet_01v8__mismatch.corner.spice
.include ~/skywater-pdk/libraries/sky130_fd_pr_ngspice/latest/cells/nfet_01v8_lvt/sky130_fd_pr__nfet_01v8_lvt__mismatch.corner.spice
.include ~/skywater-pdk/libraries/sky130_fd_pr_ngspice/latest/cells/pfet_01v8_lvt/sky130_fd_pr__pfet_01v8_lvt__mismatch.corner.spice
.include ~/skywater-pdk/libraries/sky130_fd_pr_ngspice/latest/cells/pfet_01v8_hvt/sky130_fd_pr__pfet_01v8_hvt__mismatch.corner.spice
.include ~/skywater-pdk/libraries/sky130_fd_pr_ngspice/latest/cells/nfet_g5v0d10v5/sky130_fd_pr__nfet_g5v0d10v5__mismatch.corner.spice
.include ~/skywater-pdk/libraries/sky130_fd_pr_ngspice/latest/cells/pfet_g5v0d10v5/sky130_fd_pr__pfet_g5v0d10v5__mismatch.corner.spice
.include ~/skywater-pdk/libraries/sky130_fd_pr_ngspice/latest/cells/nfet_05v0_nvt/sky130_fd_pr__nfet_05v0_nvt__mismatch.corner.spice
.include ~/skywater-pdk/libraries/sky130_fd_pr_ngspice/latest/cells/nfet_03v3_nvt/sky130_fd_pr__nfet_03v3_nvt__mismatch.corner.spice
* Resistor~/skywater-pdk/libraries/sky130_fd_pr_ngspice/latest/Capacitor
.include ~/skywater-pdk/libraries/sky130_fd_pr_ngspice/latest/models/r+c/res_typical__cap_typical.spice
.include ~/skywater-pdk/libraries/sky130_fd_pr_ngspice/latest/models/r+c/res_typical__cap_typical__lin.spice
* Special cells
.include ~/skywater-pdk/libraries/sky130_fd_pr_ngspice/latest/models/corners/tt/specialized_cells.spice
* All models
.include ~/skywater-pdk/libraries/sky130_fd_pr_ngspice/latest/models/all.spice
* Corner
.include ~/skywater-pdk/libraries/sky130_fd_pr_ngspice/latest/models/corners/tt/rf.spice

.GLOBAL GND
.GLOBAL VDD

.param vdd=1.8 vctrl=0.6 Wpbias=3 Wnbias=10 Wpint=3 Wnint=10 Lpmos=4 Lnmos=4 Mpmos=10 Mnmos=10
vdd VDD GND 'vdd'
vctrl vctrl GND 'vctrl'
vin vin GND pwl(0 0 10n 0 10.1n 'vdd' 30n 'vdd' 30.1n 0 50n 0 50.1n 'vdd' 70n 'vdd')

.control
options savecurrents
save all
+ @m.xm1.msky130_fd_pr__pfet_01v8[id]
+ @m.xm1.msky130_fd_pr__pfet_01v8[vth]
+ @m.xm1.msky130_fd_pr__pfet_01v8[gm]
+ @m.xm2.msky130_fd_pr__nfet_01v8[id]
+ @m.xm2.msky130_fd_pr__nfet_01v8[vth]
+ @m.xm2.msky130_fd_pr__nfet_01v8[gm]
+ @m.xm3.msky130_fd_pr__pfet_01v8[id]
+ @m.xm3.msky130_fd_pr__pfet_01v8[vth]
+ @m.xm3.msky130_fd_pr__pfet_01v8[gm]
+ @m.xm4.msky130_fd_pr__pfet_01v8[id]
+ @m.xm4.msky130_fd_pr__pfet_01v8[vth]
+ @m.xm4.msky130_fd_pr__pfet_01v8[gm]
+ @m.xm5.msky130_fd_pr__nfet_01v8[id]
+ @m.xm5.msky130_fd_pr__nfet_01v8[vth]
+ @m.xm5.msky130_fd_pr__nfet_01v8[gm]
+ @m.xm6.msky130_fd_pr__nfet_01v8[id]
+ @m.xm6.msky130_fd_pr__nfet_01v8[vth]
+ @m.xm6.msky130_fd_pr__nfet_01v8[gm]

op
run
print all

*tran 0.1n 1u
*run
quit
.endc

**** end user architecture code
**.ends
** flattened .save nodes
.end
