nhpoole/mixed_signal_mmwave_edge_accelerator/(commit log)

2021-07-12 added all designs, simulation SPICE files, verilog code, post-processing scripts, and documentation for chip
    [active_lowpass_filter.sch, amplitude_processing_top_level.sch, amplitude_processing_top_level_lvs.sch, amux_2to1.sch, amux_2to1_lvs.sch, analog_top_level_lvs.sch, analog_wrapper_tb.sch, and2.sch]
2021-07-12 added digital PNR flows
    [design.sdf]
2021-07-20 regenerated SAR ADC controller digital flow outputs for reference
    [sar_adc_controller.sdf]
