nhpoole/mixed_signal_mmwave_edge_accelerator/(notices)

Notices in the files:
digital_synth_pnr/deconvolution_kernel_estimator_4ksram/design/rtl/cordic_polar_to_rect.v:
Public License as published by the Free Software Foundation, either version
with no target there if the PDF file isn't present.) If not, see
License: LGPL, v3, as defined and found on www.gnu.org,
http://www.gnu.org/licenses/lgpl.html
